nathaniel-johnston/Embedded-System-Ohmmeter/(list of files, drawings)

Other design files:
PCB/Layout.dip
PCB/Schematic.dch
